michalsawczuk/StepperServo-hardware/PCB/StepperServoCAN.kicad_pcb

## KiCad design PCB/StepperServoCAN.kicad_pcb (2025-09-08)

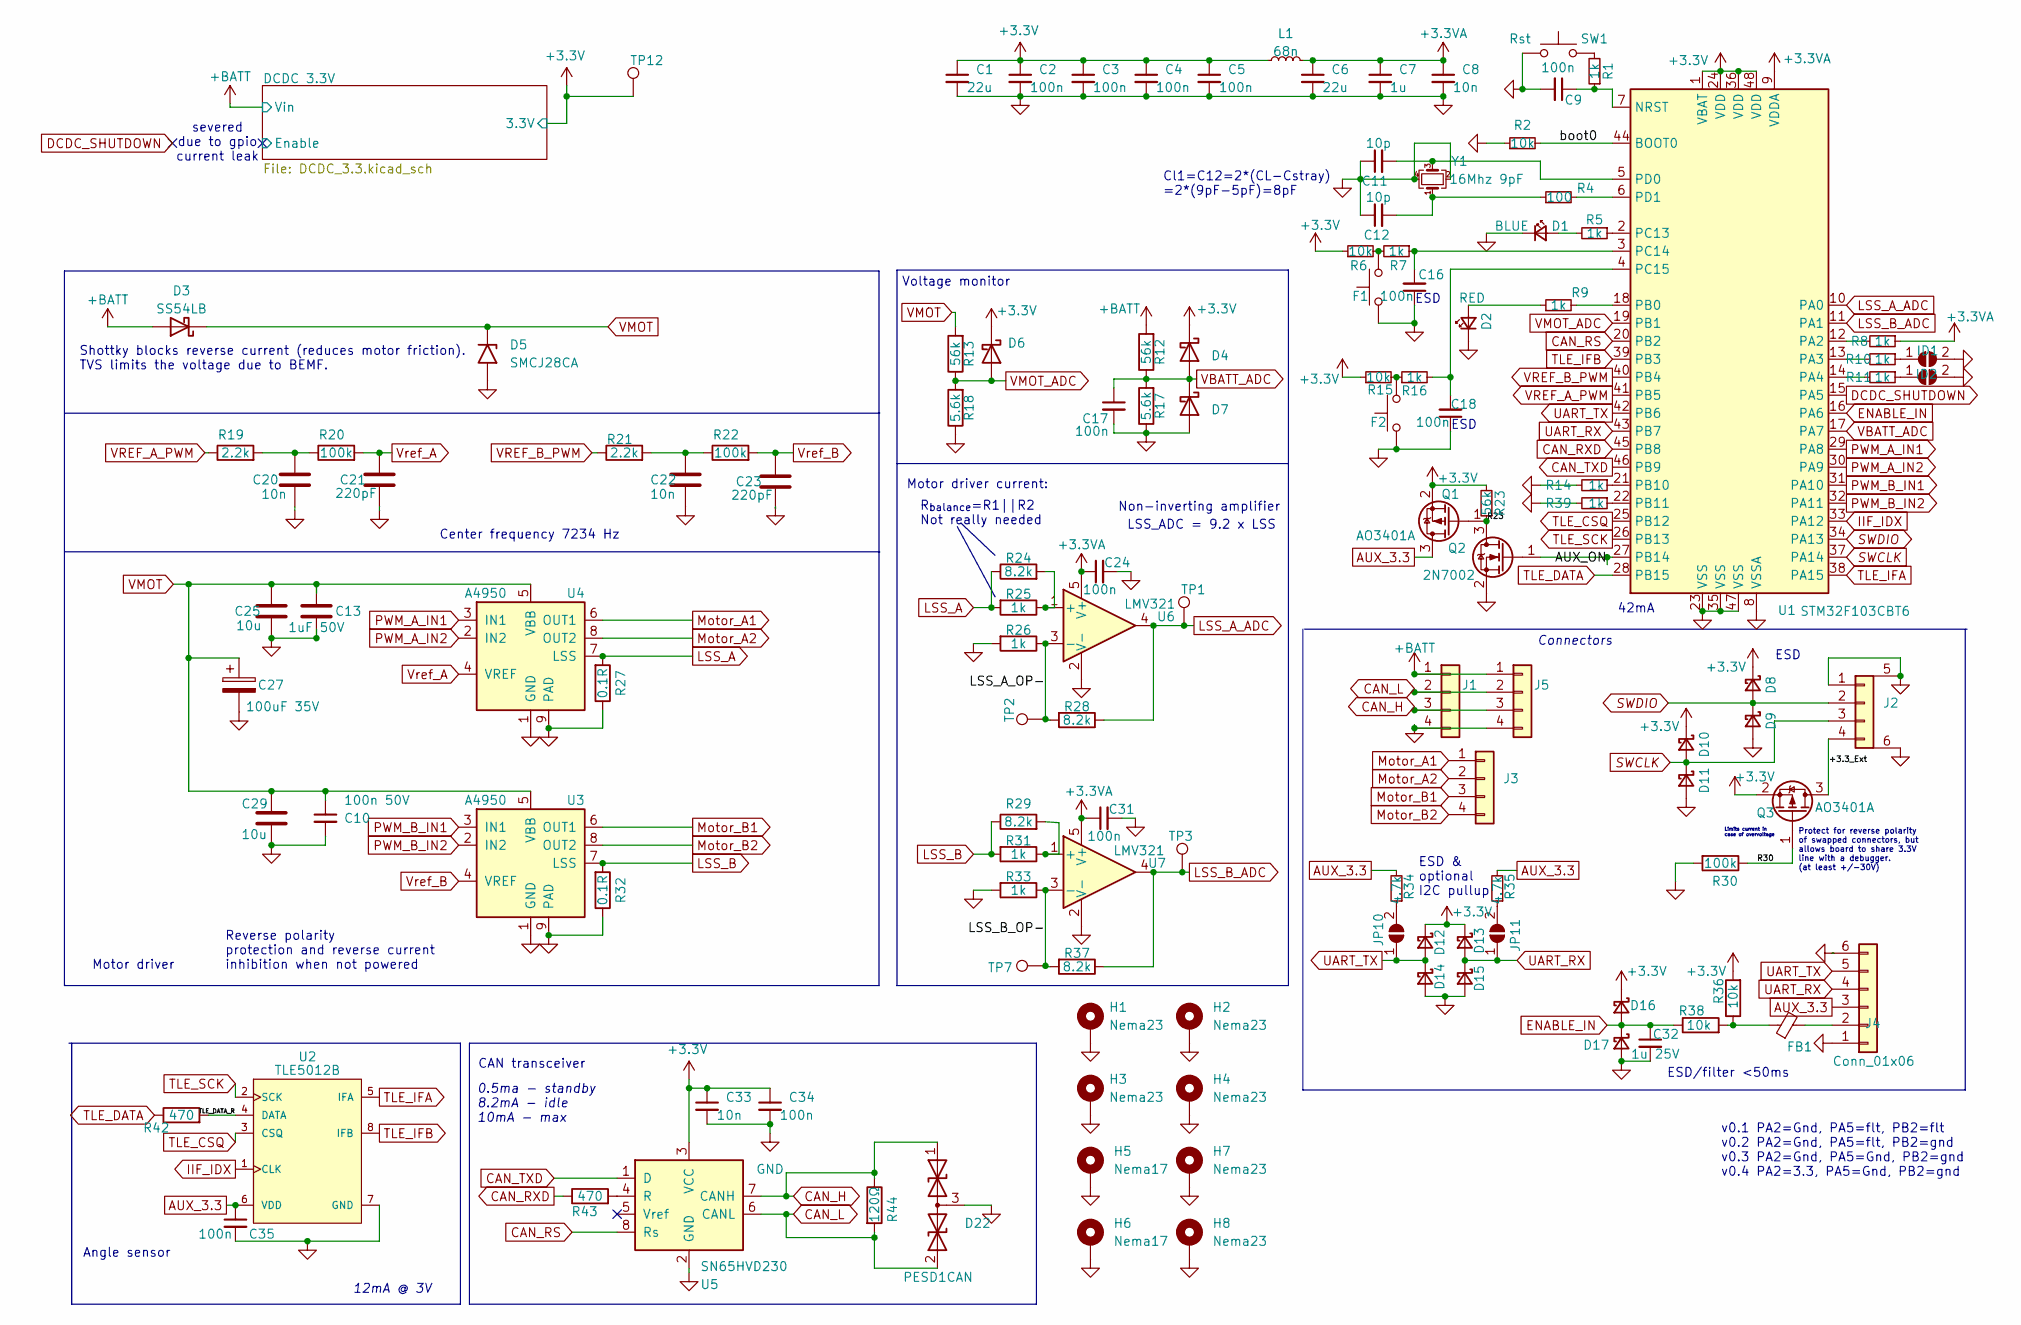
[picture p1: schematic StepperServoCAN.kicad_sch]

Parts:
C1, C6: 22u; C_0603_1608Metric; LCSC C59461
C2, C3, C4, C5, C9, C16, C17, C18, C24, C31, C34, C35: 100n; C_0402_1005Metric; LCSC C1525
C7: 1u; C_0402_1005Metric; LCSC C52923
C8, C20, C22, C33: 10n; C_0402_1005Metric; LCSC C15195
C10: 100n 50V; C_0402_1005Metric; LCSC C307331
C11, C12: 10p; C_0402_1005Metric; LCSC C32949
C13: 1uF 50V; C_0805_2012Metric; LCSC C28323
C21, C23: 220pF; C_0402_1005Metric; LCSC C1530
C25, C29: 10u; C_1206_3216Metric; LCSC C13585
C27: 100uF 35V; CP_Elec_6.3x5.7; LCSC C249982
C32: 1u 25V; C_0402_1005Metric; LCSC C52923
D1: BLUE; LED_0603_1608Metric; LCSC C2986058
D2: RED; LED_0603_1608Metric; LCSC C2286
D3: SS54LB; D_SMA; LCSC C7450527
D4, D6, D7, D8, D9, D10, D11, D12, D13, D14, D15, D16, D17: 1N5819WS; D_SOD-323; LCSC C191023
D5: SMCJ28CA; D_SMC; LCSC C19077606
D22: PESD1CAN; SOT-23; LCSC C152727
F1, F2: Fcn>; SW_SPST_TL3342; LCSC C318884
FB1: FerriteBead 200mA; L_0805_2012Metric; LCSC C1017
H1, H2, H3, H4, H7, H8: Nema23; MountingHole_3.2mm_M3_ISO14580_Pad_TopOnly
H5, H6: Nema17; MountingHole_3.2mm_M3_ISO14580_Pad_TopOnly
ID1, ID2: Jumper; SolderJumper-2_P1.3mm_Open_TrianglePad1.0x1.5mm
J1, J5: CAR; JST_XH_B4B-XH-A_1x04_P2.50mm_Vertical; LCSC C161861
J2: Debug; JST-S4B-XH-SM4-TB; LCSC C161861
J3: Motor; JST_XH_B4B-XH-A_1x04_P2.50mm_Vertical; LCSC C161861
J4: Conn_01x06; TerminalBlock_TE_282834-6_1x06_P2.54mm_Horizontal
JP10, JP11: I2C_PU; SolderJumper-2_P1.3mm_Open_RoundedPad1.0x1.5mm
L1: 68n; L_0603_1608Metric; LCSC C13415
Q1, Q3: AO3401A; SOT-23; LCSC C15127
Q2: 2N7002; SOT-23; LCSC C8545
R1, R5, R7, R8, R9, R10, R11, R14, R16, R25, R26, R31, R33, R39: 1k; R_0402_1005Metric; LCSC C11702
R2, R6, R15, R36, R38: 10k; R_0402_1005Metric; LCSC C25744
R4: 100; R_0402_1005Metric; LCSC C25076
R12, R13, R23: 56k; R_0402_1005Metric; LCSC C25796
R17, R18: 5.6k; R_0402_1005Metric; LCSC C25908
R19, R21: 2.2k; R_0402_1005Metric; LCSC C25879
R20, R22, R30: 100k; R_0402_1005Metric; LCSC C25741
R24, R28, R29, R37: 8.2k; R_0402_1005Metric; LCSC C25924
R27, R32: 0.1R; R_1206_3216Metric_Pad1.30x1.75mm_HandSolder; LCSC C201308
R34, R35: 4.7k; R_0805_2012Metric_Pad1.20x1.40mm_HandSolder; LCSC C17673
R42, R43: 470; R_0603_1608Metric; LCSC C23179
R44: 120Ω; R_1206_3216Metric_Pad1.30x1.75mm_HandSolder; LCSC C17909
SW1: Rst; SW_SPST_TL3342; LCSC C318884
TP1, TP2, TP3, TP7, TP12: Pad; TestPoint_Pad_D1.0mm
U1: STM32F103CBT6; LQFP-48_7x7mm_P0.5mm; LCSC C8734
U2: TLE5012B; Infineon-TLE5012-Level_A; LCSC C123083
U3, U4: A4950; SOIC-8-1EP_3.9x4.9mm_P1.27mm_EP2.41x3.3mm_ThermalVias; LCSC C82404
U5: SN65HVD230; SOIC-8_3.9x4.9mm_P1.27mm; LCSC C12084
U6, U7: LMV321; SOT-23-5; LCSC C7972
Y1: 16Mhz 9pF; Crystal_SMD_3225-4Pin_3.2x2.5mm; LCSC C13738

Connections:
+3.3V: C1.1, C2.1, C3.1, C4.1, C5.1, C33.1, C34.1, D4.1 (K), D6.1 (K), D8.1 (K), D10.1 (K), D12.1 (K), D13.1 (K), D16.1 (K), L1.1, Q1.2 (S), Q3.2 (S), R6.1, R15.1, R23.2, R36.2, TP12.1, U1.1 (VBAT), U1.24 (VDD), U1.36 (VDD), U1.48 (VDD), U5.3 (VCC); also elsewhere on the board
+3.3VA: C6.1, C7.1, C8.1, C24.1, C31.1, L1.2, R8.1, U1.9 (VDDA), U6.5 (V+), U7.5 (V+)
+BATT: D3.2 (A), J1.1, J5.1, R12.2; also elsewhere on the board
/+3.3_Ext: J2.4, Q3.3 (D)
/AUX_ON: Q2.1 (G), U1.27 (PB14)
/LSS_A_OP-: R26.1, R28.2, TP2.1, U6.3 (-)
/LSS_B_OP-: R33.1, R37.2, TP7.1, U7.3 (-)
/R23: Q1.1 (G), Q2.3 (D), R23.1
/R30: Q3.1 (G), R30.1
/TLE_DATA_R: R42.2, U2.4 (DATA)
/boot0: R2.2, U1.44 (BOOT0)
AUX_3.3: C35.1, J4.3, Q1.3 (D), R34.2, R35.2, U2.6 (VDD)
CAN_H: D22.1 (A1), J1.3, J5.3, R44.1, U5.7 (CANH)
CAN_L: D22.2 (A2), J1.2, J5.2, R44.2, U5.6 (CANL)
CAN_RS: U1.20 (PB2), U5.8 (Rs)
CAN_RXD: R43.1, U1.45 (PB8)
CAN_TXD: U1.46 (PB9), U5.1 (D)
DCDC_SHUTDOWN: U1.15 (PA5)
ENABLE_IN: C32.1, D16.2 (A), D17.1 (K), R38.1, U1.16 (PA6)
GND: C1.2, C2.2, C3.2, C4.2, C5.2, C6.2, C7.2, C8.2, C9.2, C10.2, C11.1, C12.1, C13.2, C16.1, C17.2, C18.1, C20.2, C21.2, C22.2, C23.2, C24.2, C25.2, C27.2, C29.2, C31.2, C32.2, C33.2, C34.2, C35.2, D1.1 (K), D2.1 (K), D5.2 (A2), D7.2 (A), D9.2 (A), D11.2 (A), D14.2 (A), D15.2 (A), D17.2 (A), D22.3 (common), F1.2, F2.2, H1.1, H2.1, H3.1, H4.1, H5.1, H6.1, H7.1, H8.1, ID1.2 (B), ID2.2 (B), J1.4, J2.1, J2.5 (Mount), J2.6 (Mount), J4.1, J4.6, J5.4, Q2.2 (S), R2.1, R14.2, R17.1, R18.1, R26.2, R27.1, R30.2, R32.1, R33.2, R39.2, SW1.1, U1.8 (VSSA), U1.23 (VSS), U1.35 (VSS), U1.47 (VSS), U2.7 (GND), U3.1 (GND), U3.9 (PAD), U4.1 (GND), U4.9 (PAD), U5.2 (GND), U6.2 (V-), U7.2 (V-), Y1.2, Y1.4; also elsewhere on the board
IIF_IDX: U1.33 (PA12), U2.1 (CLK)
LSS_A: R24.1, R25.2, R27.2, U4.7 (LSS)
LSS_A_ADC: R28.1, TP1.1, U1.10 (PA0), U6.4
LSS_B: R29.1, R31.2, R32.2, U3.7 (LSS)
LSS_B_ADC: R37.1, TP3.1, U1.11 (PA1), U7.4
Motor_A1: J3.1, U4.6 (OUT1)
Motor_A2: J3.2, U4.8 (OUT2)
Motor_B1: J3.3, U3.6 (OUT1)
Motor_B2: J3.4, U3.8 (OUT2)
unnamed: C12.2, R4.1, Y1.1
unnamed: C20.1, R19.2, R20.1
unnamed: C22.1, R21.2, R22.1
unnamed: D1.2 (A), R5.2
unnamed: D2.2 (A), R9.1
unnamed: F1.1, R6.2, R7.2
unnamed: F2.1, R15.2, R16.1
unnamed: FB1.1, R36.1, R38.2
unnamed: ID1.1 (A), R10.1
unnamed: ID2.1 (A), R11.1
unnamed: FB1.2, J4.2
unnamed: JP10.2 (B), R34.1
unnamed: JP11.2 (B), R35.1
unnamed: R1.2, SW1.2
unnamed: C9.1, R1.1, U1.7 (NRST)
unnamed: R8.2, U1.12 (PA2)
unnamed: R10.2, U1.13 (PA3)
unnamed: R11.2, U1.14 (PA4)
unnamed: R9.2, U1.18 (PB0)
unnamed: R14.1, U1.21 (PB10)
unnamed: R39.1, U1.22 (PB11)
unnamed: R5.1, U1.2 (PC13)
unnamed: C16.2, R7.1, U1.3 (PC14)
unnamed: C18.2, R16.2, U1.4 (PC15)
unnamed: C11.2, U1.5 (PD0), Y1.3
unnamed: R4.2, U1.6 (PD1)
unnamed: R43.2, U5.4 (R)
unnamed: R24.2, R25.1, U6.1 (+)
unnamed: R29.2, R31.1, U7.1 (+)
PWM_A_IN1: U1.29 (PA8), U4.3 (IN1)
PWM_A_IN2: U1.30 (PA9), U4.2 (IN2)
PWM_B_IN1: U1.31 (PA10), U3.3 (IN1)
PWM_B_IN2: U1.32 (PA11), U3.2 (IN2)
SWCLK: D10.2 (A), D11.1 (K), J2.3, U1.37 (PA14)
SWDIO: D8.2 (A), D9.1 (K), J2.2, U1.34 (PA13)
TLE_CSQ: U1.25 (PB12), U2.3 (CSQ)
TLE_DATA: R42.1, U1.28 (PB15)
TLE_IFA: U1.38 (PA15), U2.5 (IFA)
TLE_IFB: U1.39 (PB3), U2.8 (IFB)
TLE_SCK: U1.26 (PB13), U2.2 (SCK)
UART_RX: D13.2 (A), D15.1 (K), J4.4, JP11.1 (A), U1.43 (PB7)
UART_TX: D12.2 (A), D14.1 (K), J4.5, JP10.1 (A), U1.42 (PB6)
VBATT_ADC: C17.1, D4.2 (A), D7.1 (K), R12.1, R17.2, U1.17 (PA7)
VMOT: C10.1, C13.1, C25.1, C27.1, C29.1, D3.1 (K), D5.1 (A1), R13.2, U3.5 (VBB), U4.5 (VBB)
VMOT_ADC: D6.2 (A), R13.1, R18.2, U1.19 (PB1)
VREF_A_PWM: R19.1, U1.41 (PB5)
VREF_B_PWM: R21.1, U1.40 (PB4)
Vref_A: C21.1, R20.2, U4.4 (VREF)
Vref_B: C23.1, R22.2, U3.4 (VREF)

Notes on the sheet:
LSS_ADC = 9.2 x LSS
severed due to gpio current leak
42mA
ESD & optional I2C pullup
R_{balance}=R1||R2 Not really needed
v0.1 PA2=Gnd, PA5=flt, PB2=flt v0.2 PA2=Gnd, PA5=flt, PB2=gnd v0.3 PA2=Gnd, PA5=Gnd, PB2=gnd v0.4 PA2=3.3, PA5=Gnd, PB2=gnd
CAN transceiver
Non-inverting amplifier
Center frequency 7234 Hz
Angle sensor
Protect for reverse polarity of swapped connectors, but allows board to share 3.3V line with a debugger. (at least +/-30V)
ESD
Motor driver
ESD/filter <50ms
Shottky blocks reverse current (reduces motor friction). TVS limits the voltage due to BEMF.
Limits current in case of overvoltage
Connectors
12mA @ 3V
Reverse polarity protection and reverse current inhibition when not powered
Voltage monitor
0.5ma - standby 8.2mA - idle 10mA - max
Cl1=C12=2*(CL-Cstray) =2*(9pF-5pF)=8pF
Motor driver current:

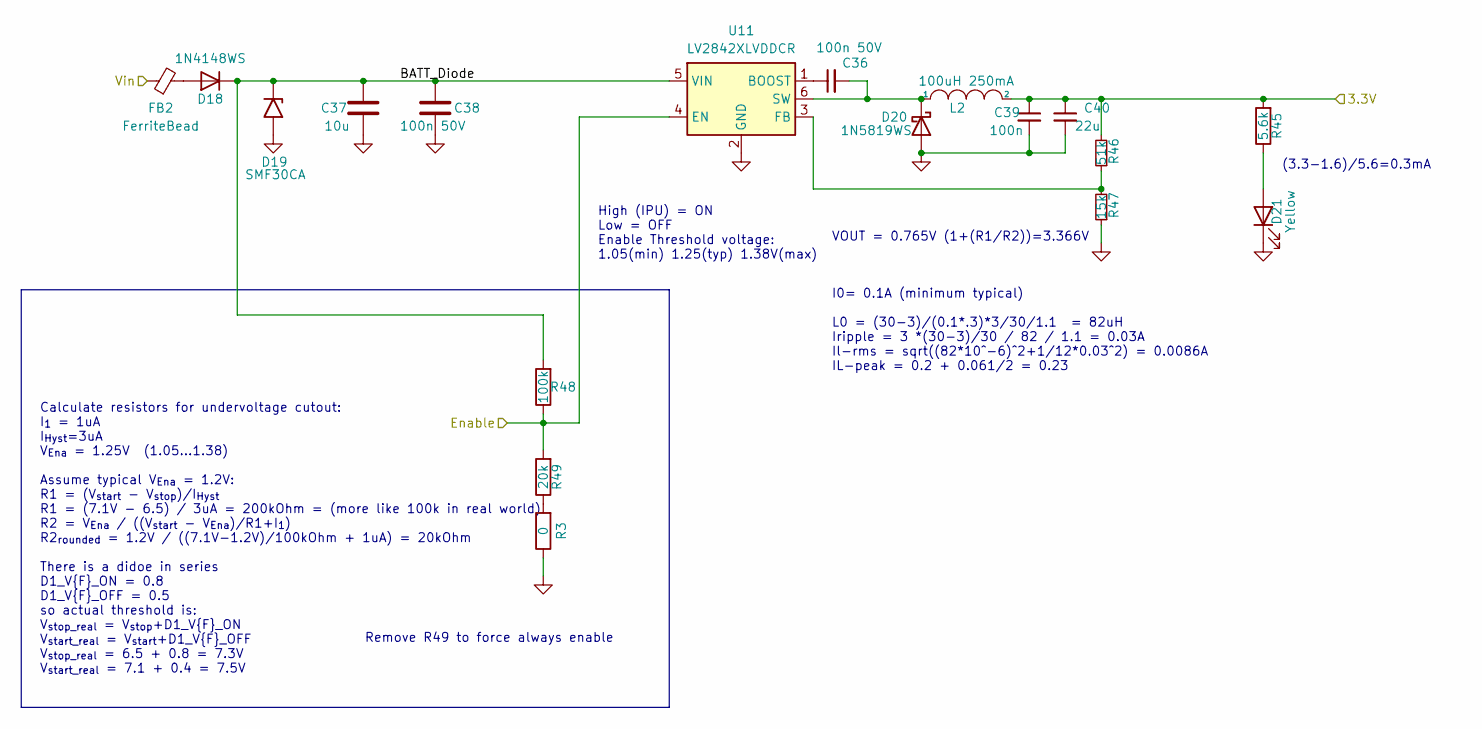
[picture p2: schematic DCDC_3.3.kicad_sch]

Parts:
C36, C38: 100n 50V; C_0402_1005Metric; LCSC C307331
C37: 10u; C_0805_2012Metric; LCSC C440198
C39: 100n; C_0402_1005Metric; LCSC C1525
C40: 22u; C_0603_1608Metric; LCSC C59461
D18: 1N4148WS; D_SOD-323; LCSC C2128
D19: SMF30CA; D_SMF; LCSC C2990493
D20: 1N5819WS; D_SOD-323; LCSC C191023
D21: Yellow; LED_0603_1608Metric; LCSC C72038
FB2: FerriteBead; L_0603_1608Metric; LCSC C1002
L2: 100uH 250mA; L_Sunlord_SWPA3012S; LCSC C167741
R3: 0; R_0402_1005Metric
R45: 5.6k; R_0402_1005Metric; LCSC C25908
R46: 51k; R_0402_1005Metric; LCSC C25794
R47: 15k; R_0402_1005Metric; LCSC C25756
R48: 100k; R_0402_1005Metric; LCSC C25741
R49: 20k; R_0402_1005Metric; LCSC C25765
U11: LV2842XLVDDCR; TSOT-23-6; LCSC C225807

Connections:
+3.3V: C39.1, C40.1, L2.2, R45.2, R46.2; also elsewhere on the board
+BATT: FB2.1; also elsewhere on the board
/DCDC 3.3V/BATT_Diode: C37.1, C38.1, D18.1 (K), D19.1 (A1), R48.2, U11.5 (VIN)
/DCDC 3.3V/Enable: R48.1, R49.2, U11.4 (EN)
GND: C37.2, C38.2, C39.2, C40.2, D19.2 (A2), D20.2 (A), D21.1 (K), R3.1, R47.1, U11.2 (GND); also elsewhere on the board
unnamed: D18.2 (A), FB2.2
unnamed: C36.2, D20.1 (K), L2.1, U11.6 (SW)
unnamed: D21.2 (A), R45.1
unnamed: R3.2, R49.1
unnamed: C36.1, U11.1 (BOOST)
unnamed: R46.1, R47.2, U11.3 (FB)

Notes on the sheet:
(3.3-1.6)/5.6=0.3mA
Calculate resistors for undervoltage cutout: I_{1} = 1uA I_{Hyst}=3uA V_{Ena} = 1.25V (1.05...1.38) Assume typical V_{Ena} = 1.2V: R1 = (V_{start} - V_{stop})/I_{Hyst} R1 = (7.1V - 6.5) / 3uA = 200kOhm = (more like 100k in real world) R2 = V_{Ena} / ((V_{start} - V_{Ena})/R1+I_{1}) R2_{rounded} = 1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
I0= 0.1A (minimum typical) L0 = (30-3)/(0.1*.3)*3/30/1.1 = 82uH Iripple = 3 *(30-3)/30 / 82 / 1.1 = 0.03A Il-rms = sqrt((82*10^-6)^2+1/12*0.03^2) = 0.0086A IL-peak = 0.2 + 0.061/2 = 0.23
Remove R49 to force always enable
High (IPU) = ON Low = OFF Enable Threshold voltage: 1.05(min) 1.25(typ) 1.38V(max)
VOUT = 0.765V (1+(R1/R2))=3.366V

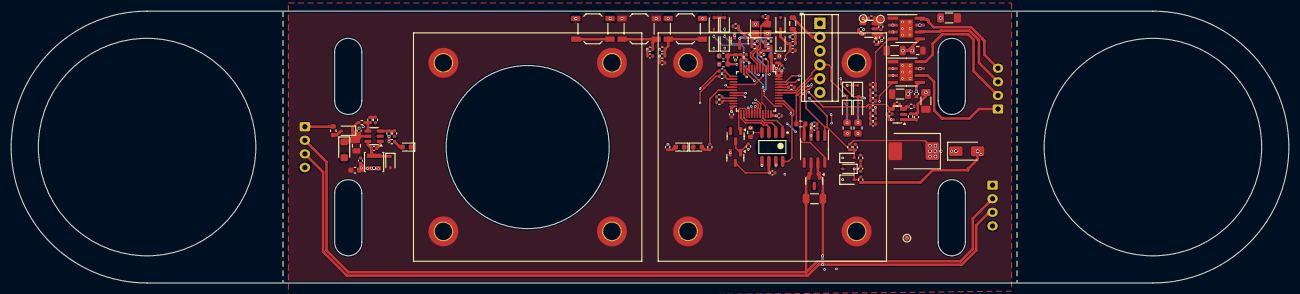
[picture p3: board StepperServoCAN.kicad_pcb from above]

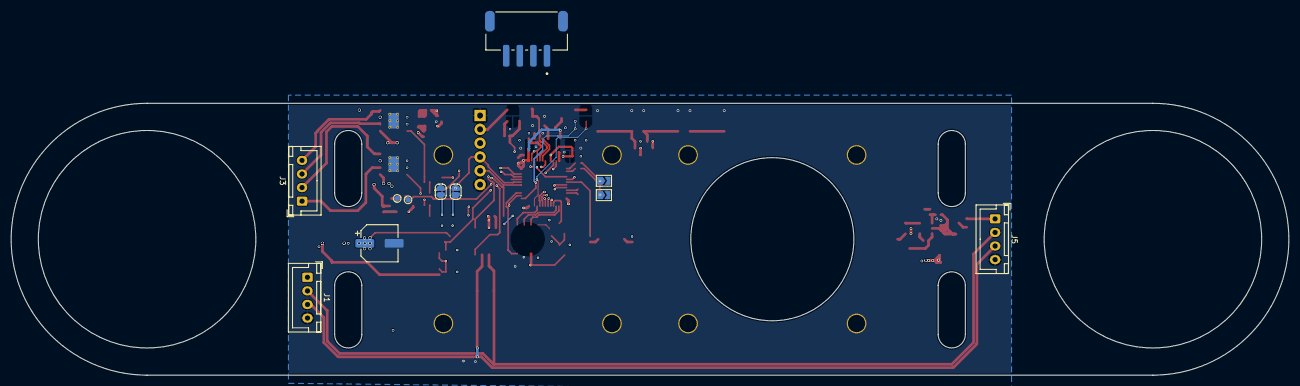
[picture p4: board StepperServoCAN.kicad_pcb from below]

Board: 4 copper layers, 235.0 x 50.0 mm, 144 parts (11 on the bottom side), 85 nets.
