michalsawczuk/StepperServo-hardware/(notices)

Notices in the files:
PCB/StepperServoCAN.kicad_sch:
Licensed under CERN-OHL-S v2
